alinajm7/Haptisense/README.md

# Haptisense
Documentation and Projects for haptic feedback systems. Explore and contribute to the tactile feedback technology.

# Project General View
- **[Hardware](./hardware/)**
  - **[Electronic_components](./hardware/electronic_components/)**
  - **[Physical_components](./hardware/physical_components/)**
- **[Software](./software/)**
  - **[Microcontroller_firmware](./software/microcontroller_firmware/)**
  - **[UNITY_packages](./software/unity_packages/)**<br>
- [Docs](./docs/)<br>
- [LICENSE.md](./LICENSE.md)<br>
