alinajm7/Haptisense/software/unity_packages/README.md

# Unity Packages

This repository contains useful packages for managing haptic devices and related functionalities.

## Overview of Packages

- **[Haptic Device Controller](./haptic_device_controller):** A package for controlling haptic devices.

Related & Useful packages:
- **[Path Movement (Shape Drawing)](./moving_on_path_(shape_drawing)):** A package for simulating object movement along a path, useful for replicating stroking or shape drawing with a haptic device.
- **[Questionnaire](https://github.com/alinajm7/Unity-Questionnaire.git):** A package for managing questionnaires and collecting results.
