alinajm7/Haptisense/software/unity_packages/haptic_device_controller/ver01 - Device with esp32_wroom_dev/README.md

# Haptic Device Integration for Unity

This guide explains how to integrate the "AliN_HapticDevice" package into your Unity project and provides a manual setup process for configuring the haptic device ver 1.0

## How to Run the Haptic Device

1. **Download the Package:**  
   Download the "AliN_HapticDevice" package and add it to your Unity project.

2. **Sample Scene:**  
   A fully functioning sample scene is provided in the `Sample Scenes` folder to help you get started quickly.

## Manual Setup

To manually set up the haptic device in your Unity project, follow these steps:

### 1. Setting Up the Communication Manager

1. **Create an Empty GameObject:**  
   - In your scene, create an empty GameObject.
   - Add the `MicroControllerCommunicationManager` component to this GameObject.  
  
### 2. Setting Up the Actuator Manager

1. **Create Another Empty GameObject:**  
   - Add an empty GameObject to manage the actuators.
   - This GameObject will serve as the parent for actuator objects.

2. **Add the Following Components:**

   - **Actuators Manager:**  
     Manages the behavior of actuators, including properties like scanning distance, power factor, and distance-based weighting.  
     
     **Properties:**
     - **Scanning Distance:** (`scaningDistance`)  
       Defines the range within which actuators can detect tangible objects. Default is 10 units.
       
     - **Power Factor:** (`powerFactor`)  
       Adjusts the intensity of actuator responses based on proximity. Higher values increase sensitivity to closer objects. Default is 2.0.
       
     - **Minimum Actuator Value Threshold:** (`acuatorMinValueThreshold`)  
       The minimum value an actuator can output. Values below this threshold are considered inactive. Default is 0.14.
       
     - **Maximum Actuator Value:** (`maxActuatorValue`)  
       The maximum intensity an actuator can reach. Default is 1.0.
       
     - **Show Actuator Values:** (`ShowActuatorValues`)  
       Enables or disables the display of actuator values in the scene. Default is enabled.
       
     - **Gradient:** (`gradient`)  
       Defines the color gradient used for visual feedback based on actuator values.

   - **Actuator Data Sender:**  
     Required for the Actuators Manager to send calculated data to the Device Manager.

   - **Optional Components:**
     - **Actuator Layout:**  
       Automatically creates a pattern of actuators based on specified parameters.
       
     - **Actuator Object Mapper:**  
       Maps all actuator cells onto any 3D object surface with a Collider (including Mesh Collider) using ray projecting mapping in specific direction .

### 3. Example Setup

Below is an example image showing a typical setup:

Haptic Device Setup

## Additional Notes

- Ensure all GameObjects with actuators have the necessary components as listed above.
- Use the sample scene for reference if you encounter any issues.
