alinajm7/Haptisense/project_tree_view.md

# Project Tree View
- [LICENSE.md](https://github.com/alinajm7/Haptisense/blob/main/LICENSE.md)
- [README.md](https://github.com/alinajm7/Haptisense/blob/main/README.md)
- [docs](https://github.com/alinajm7/Haptisense/tree/main/docs)/
  - [*](https://github.com/alinajm7/Haptisense/blob/main/docs/*)
- [generate_tree.sh](https://github.com/alinajm7/Haptisense/blob/main/generate_tree.sh)
- [hardware](https://github.com/alinajm7/Haptisense/tree/main/hardware)/
  - [electronic_components](https://github.com/alinajm7/Haptisense/tree/main/hardware/electronic_components)/
    - [01_microcontrollers_modules](https://github.com/alinajm7/Haptisense/tree/main/hardware/electronic_components/01_microcontrollers_modules)/
      - [microcontrollers_note.md](https://github.com/alinajm7/Haptisense/blob/main/hardware/electronic_components/01_microcontrollers_modules/microcontrollers_note.md)
    - [02_power_driver_modules](https://github.com/alinajm7/Haptisense/tree/main/hardware/electronic_components/02_power_driver_modules)/
      - [*](https://github.com/alinajm7/Haptisense/blob/main/hardware/electronic_components/02_power_driver_modules/*)
    - [03_haptic_interface_modules](https://github.com/alinajm7/Haptisense/tree/main/hardware/electronic_components/03_haptic_interface_modules)/
      - [*](https://github.com/alinajm7/Haptisense/blob/main/hardware/electronic_components/03_haptic_interface_modules/*)
    - [10_integrated_designs](https://github.com/alinajm7/Haptisense/tree/main/hardware/electronic_components/10_integrated_designs)/
      - [*](https://github.com/alinajm7/Haptisense/blob/main/hardware/electronic_components/10_integrated_designs/*)
  - [physical_components](https://github.com/alinajm7/Haptisense/tree/main/hardware/physical_components)/
    - [3d_models](https://github.com/alinajm7/Haptisense/tree/main/hardware/physical_components/3d_models)/
      - [cases](https://github.com/alinajm7/Haptisense/tree/main/hardware/physical_components/3d_models/cases)/
        - [*](https://github.com/alinajm7/Haptisense/blob/main/hardware/physical_components/3d_models/cases/*)
    - [laser_cut_files](https://github.com/alinajm7/Haptisense/tree/main/hardware/physical_components/laser_cut_files)/
      - [*](https://github.com/alinajm7/Haptisense/blob/main/hardware/physical_components/laser_cut_files/*)
- [project_tree_view.md](https://github.com/alinajm7/Haptisense/blob/main/project_tree_view.md)
- [software](https://github.com/alinajm7/Haptisense/tree/main/software)/
  - [microcontroller_firmware](https://github.com/alinajm7/Haptisense/tree/main/software/microcontroller_firmware)/
    - [*](https://github.com/alinajm7/Haptisense/blob/main/software/microcontroller_firmware/*)
  - [unity_application](https://github.com/alinajm7/Haptisense/tree/main/software/unity_application)/
    - [*](https://github.com/alinajm7/Haptisense/blob/main/software/unity_application/*)
- [tree_view.md](https://github.com/alinajm7/Haptisense/blob/main/tree_view.md)
