alinajm7/Haptisense/hardware/electronic_components/02_power_driver_modules/Driver_AliNk_02/README.md

Backup of Electronic Components' Schematics and PCB Design in EasyEDA [https://easyeda.com/]
