alinajm7/Haptisense/hardware/electronic_components/01_microcontrollers_modules/Microcontroller_AliNk_02/Dual ESP32 2024/BOM_Dual-ESP32-S3-Controller_2024-10-15.csv

ID | Name | Designator | Footprint | Quantity | Manufacturer Part | Manufacturer | Supplier | Supplier Part | Price | Pins | Contributor | JLCPCB Part Class | LCSC Assembly | Package Display | SMT Type | link
1 | 10uF/25V (20%) | C1 | C0603 | 1 | CL10A106MA8NRNC | SAMSUNG | LCSC | C96446 | 0.017 | 2 | Sanjoy Biswas |  | Yes |  | Extend
2 | 0.1uF/50V(10%) | C2,C3,C4,C10 | C0603 | 4 | 0603B104K500NT | FH(风华) | LCSC | C30926 | 0.002 | 2 | mubashirashfaq | Extended Part |  |  |  | https://lcsc.com/eda_search?q=C30926&%26type=1&ref=editor
3 | 10uF/25V(10%) | C6,C7 | C0805 | 2 | CL21A106KAYNNNE | SAMSUNG(三星) | LCSC | C15850 | 0.01 | 2 |  | Basic Part
4 | 1uF/16V(10%) | C8 | C0603 | 1 | CL10A105KO8NNNC | SAMSUNG(三星) | LCSC | C1592 | 0.003 | 2 |  | Extended Part
5 | 0.1uF | C9 | C0603 | 1 | 0603B104K500NT | FH(风华) | LCSC | C30926 | 0.002 | 2 | mubashirashfaq | Extended Part |  |  |  | https://lcsc.com/eda_search?q=C30926&%26type=1&ref=editor
6 | 10uF | C11 | C0805 | 1 | CL21A106KAYNNNE | SAMSUNG(三星) | LCSC | C15850 | 0.01 | 2 |  | Basic Part
7 | 22uF | C12 | C1206 | 1 | CL31A226KAHNNNE | SAMSUNG(三星) | LCSC | C12891 | 0.045 | 2 |  | Basic Part
8 | 1uF/16V(10%) | C17 | C0603 | 1 | CL10A105KO8NNNC | SAMSUNG | LCSC | C1592 | 0.003 | 2 |  | Extended Part
9 | LESD9D5.0CT5G | D2,D3,D4 | SOD-923_L0.8-W0.6-LS1.0-BI | 3 | LESD9D5.0CT5G | LRC(乐山无线电) | LCSC | C136165 | 0.018 | 2 | LCSC | Extended Part
10 | SS52_C727064 | D5,D6 | SMA_L4.3-W2.6-LS5.1-R-RD | 2 | SS52 | TWGMC(台湾迪嘉) | LCSC | C727064 | 0.046 | 2 | LCSC | Extended Part
11 | AFC24-S60FIC-00 | FPC1 | FPC-SMD_P0.50-60P_QCHF-SM-H2.0 | 1 | AFC24-S60FIC-00 | JS(钜硕电子) | LCSC | C262298 | 0.363 | 62 | LCSC | Extended Part
12 | PZ254R-11-03P | H2 | HDR-TH_3P-P2.54-H-M-W10.4 | 1 | PZ254R-11-03P | XFCN(兴飞) | LCSC | C492411 | 0.019 | 3 | LCSC | Extended Part
13 | D-R080508L3-KS2 | LED1 | LED0805-RD | 1 | D-R080508L3-KS2 | ARKLED(方舟) | LCSC | C130114 | 0.016 | 2 | LCSC | Extended Part
14 | XL-1608UBC-04 | LED4 | LED0603-RD_BLUE | 1 | XL-1608UBC-04 | XINGLIGHT(成兴光) | LCSC | C965807 | 0.003 | 2 | LCSC | Extended Part
15 | XL-1608UGC-04 | LED6 | LED0603-RD_GREEN | 1 | XL-1608UGC-04 | XINGLIGHT(成兴光) | LCSC | C965804 | 0.004 | 2 | lcsc | Extended Part
16 | L8050QLT1G | Q1 | SOT-23-3_L2.9-W1.3-P1.90-LS2.4-BR | 1 | L8050QLT1G | LRC(乐山无线电) | LCSC | C49581 | 0.012 | 3 |  | Extended Part |  | No
17 | L8050QLT1G | Q2 | SOT-23-3_L2.9-W1.3-P1.90-LS2.4-BR | 1 | L8050QLT1G | LRC(乐山无线电) | LCSC | C49581 | 0.012 | 3 |  | Extended Part
18 | 0Ω | R1,R4,R5,R8,R15 | R0603 | 5 | 0603WAF0000T5E | UNI-ROYAL(厚声) | LCSC | C21189 | 0.001 | 2 |  | Basic Part
19 | 10kΩ(0.5%) | R3,R6,R7,R14 | R0603 | 4 | 0603WAD1002T5E | UNI-ROYAL(厚声) | LCSC | C167144 | 0.004 | 2 | LCSC | Extended Part
20 | 4.7kΩ | R9,R10 | R1206 | 2 | PTFR1206B4K70P9 | RESI(开步睿思） | LCSC | C351460 | 0.208 | 2 | LCSC | Extended Part
21 | 47.5kΩ (0.5%) | R12 | R0402 | 1 | AR02DTC4752 | Viking(光颉) | LCSC | C319605 | 0.011 | 2 | LCSC | Extended Part
22 | 1kΩ (0.5%) | R13 | R0402 | 1 | AR02DTD1001 | Viking(光颉) | LCSC | C319807 | 0.011 | 2 | LCSC | Extended Part
23 | 22.1kΩ | R16 | R0402 | 1 | RTT022212FTH | RALEC(旺诠) | LCSC | C102896 | 0.001 | 2 |  | Extended Part
24 | 110Ω | R17,R18 | R0603 | 2 | 0603WAF1100T5E | UNI-ROYAL(厚声) | LCSC | C22781 | 0.001 | 2 |  | Extended Part
25 | 1kΩ | R22 | R0603 | 1 | RT0603BRD071KL | YAGEO(国巨) | LCSC | C110776 | 0.021 | 2 |  | Extended Part
26 | SKRPARE010 | SW1 | KEY-SMD_4P-L4.2-W3.2-P2.20-LS4.6 | 1 | SKRPARE010 | ALPSALPINE(阿尔卑斯阿尔派) | LCSC | C341730 | 0.121 | 4 | LCSC | Extended Part
27 | SKRPACE010 | SW2 | KEY-SMD_4P-L4.2-W3.2-P2.20-LS4.6 | 1 | SKRPACE010 | ALPSALPINE(阿尔卑斯阿尔派) | LCSC | C139797 | 0.056 | 4 | LCSC | Extended Part
28 | K3-2268D-F1 | SW4 | SW-TH_K3-2268D-F1 | 1 | K3-2268D-F1 | 韩国韩荣 | LCSC | C128958 | 0.506 | 12 | LCSC | Extended Part
29 | CP2102N-A02-GQFN28R | U2 | QFN-28_L5.0-W5.0-P0.50-TL-EP3.3 | 1 | CP2102N-A02-GQFN28R | SKYWORKS/SILICON LABS(芯科) | LCSC | C964632 | 2.03 | 29 | LCSC | Extended Part
30 | LM1085R-3.3 | U6 | TO-263-3L_L10.0-W9.2-P2.54-TL | 1 | LM1085R-3.3 | HTC | LCSC | C126016 | 0.614 | 4 |  | Extended Part
31 | ESP32-S3-MINI-1U-N8 | U9,U10 | BULETM-SMD_ESPRESSIF_ESP32-S3-MINI-1U-N8 | 2 | ESP32-S3-MINI-1U-N8 | ESPRESSIF(乐鑫) | LCSC | C2980299 | 3.855 | 65 | LCSC | Extended Part
32 | HC-TYPE-C-16P-01A-G | USB1 | USB-C-SMD_G-SWITCH_GT-USB-7010EN | 1 | HC-TYPE-C-16P-01A-G | HCTL(华灿天禄) | LCSC | C2997435 | 0.133 | 16 | lcsc | Extended Part
