alinajm7/Haptisense/hardware/electronic_components/03_haptic_interface_modules/Interface_AliNk_02/Vibrator Interface Flex 2024/BOM_Vibrator-Interface-Flex-Board_2024-10-15.csv

ID | Name | Designator | Footprint | Quantity | Manufacturer Part | Manufacturer | Supplier | Supplier Part | Price | Pins | Contributor | JLCPCB Part Class | link
1 | 0.1uF | C1,C2,C3,C4,C5,C6,C7,C8,C9,C10,C11,C12,C13,C14,C15,C16,C17,C18,C19,C20,C21,C22,C23,C24,C25,C26,C27,C28,C29,C30,C31,C32,C33,C34,C35,C36,C37,C38,C39,C40,C41,C42,C43,C44,C45,C46,C47,C48,C49,C50,C51,C52,C53,C54,C55,C56,C57,C58 | C0603 | 58 | 0603B104K500NT | FH(风华) | LCSC | C30926 | 0.002 | 2 | mubashirashfaq | Extended Part | https://lcsc.com/eda_search?q=C30926&%26type=1&ref=editor
2 | THD0812F-120BV-GF | CN1 | CONN-SMD_120P-P0.80_THD0812F-120BV-GF | 1 | THD0812F-120BV-GF | THD(台华达) | LCSC | C2841037 | 0.963 | 120 | LCSC | Extended Part
3 | 1N5819WS | D1,D2,D3,D4,D5,D6,D7,D8,D9,D10,D11,D12,D13,D14,D15,D16,D17,D18,D19,D20,D21,D22,D23,D24,D25,D26,D27,D28,D29,D30,D31,D32,D33,D34,D35,D36,D37,D38,D39,D40,D41,D42,D43,D44,D45,D46,D47,D48,D49,D50,D51,D52,D53,D54,D55,D56,D57,D58 | SOD-323_L1.8-W1.3-LS2.5-RD | 58 | 1N5819WS | Hottech(合科泰) | LCSC | C191023 | 0.008 | 2 | LCSC | Basic Part
