alinajm7/Haptisense/hardware/electronic_components/01_microcontrollers_modules/Microcontroller_AliNk_02/Dual ESP32 2024/Schematic_Dual-ESP32-S3-Controller_2024-10-15.pdf

# ESP32-S3

# USB to UART Bridge Circuit

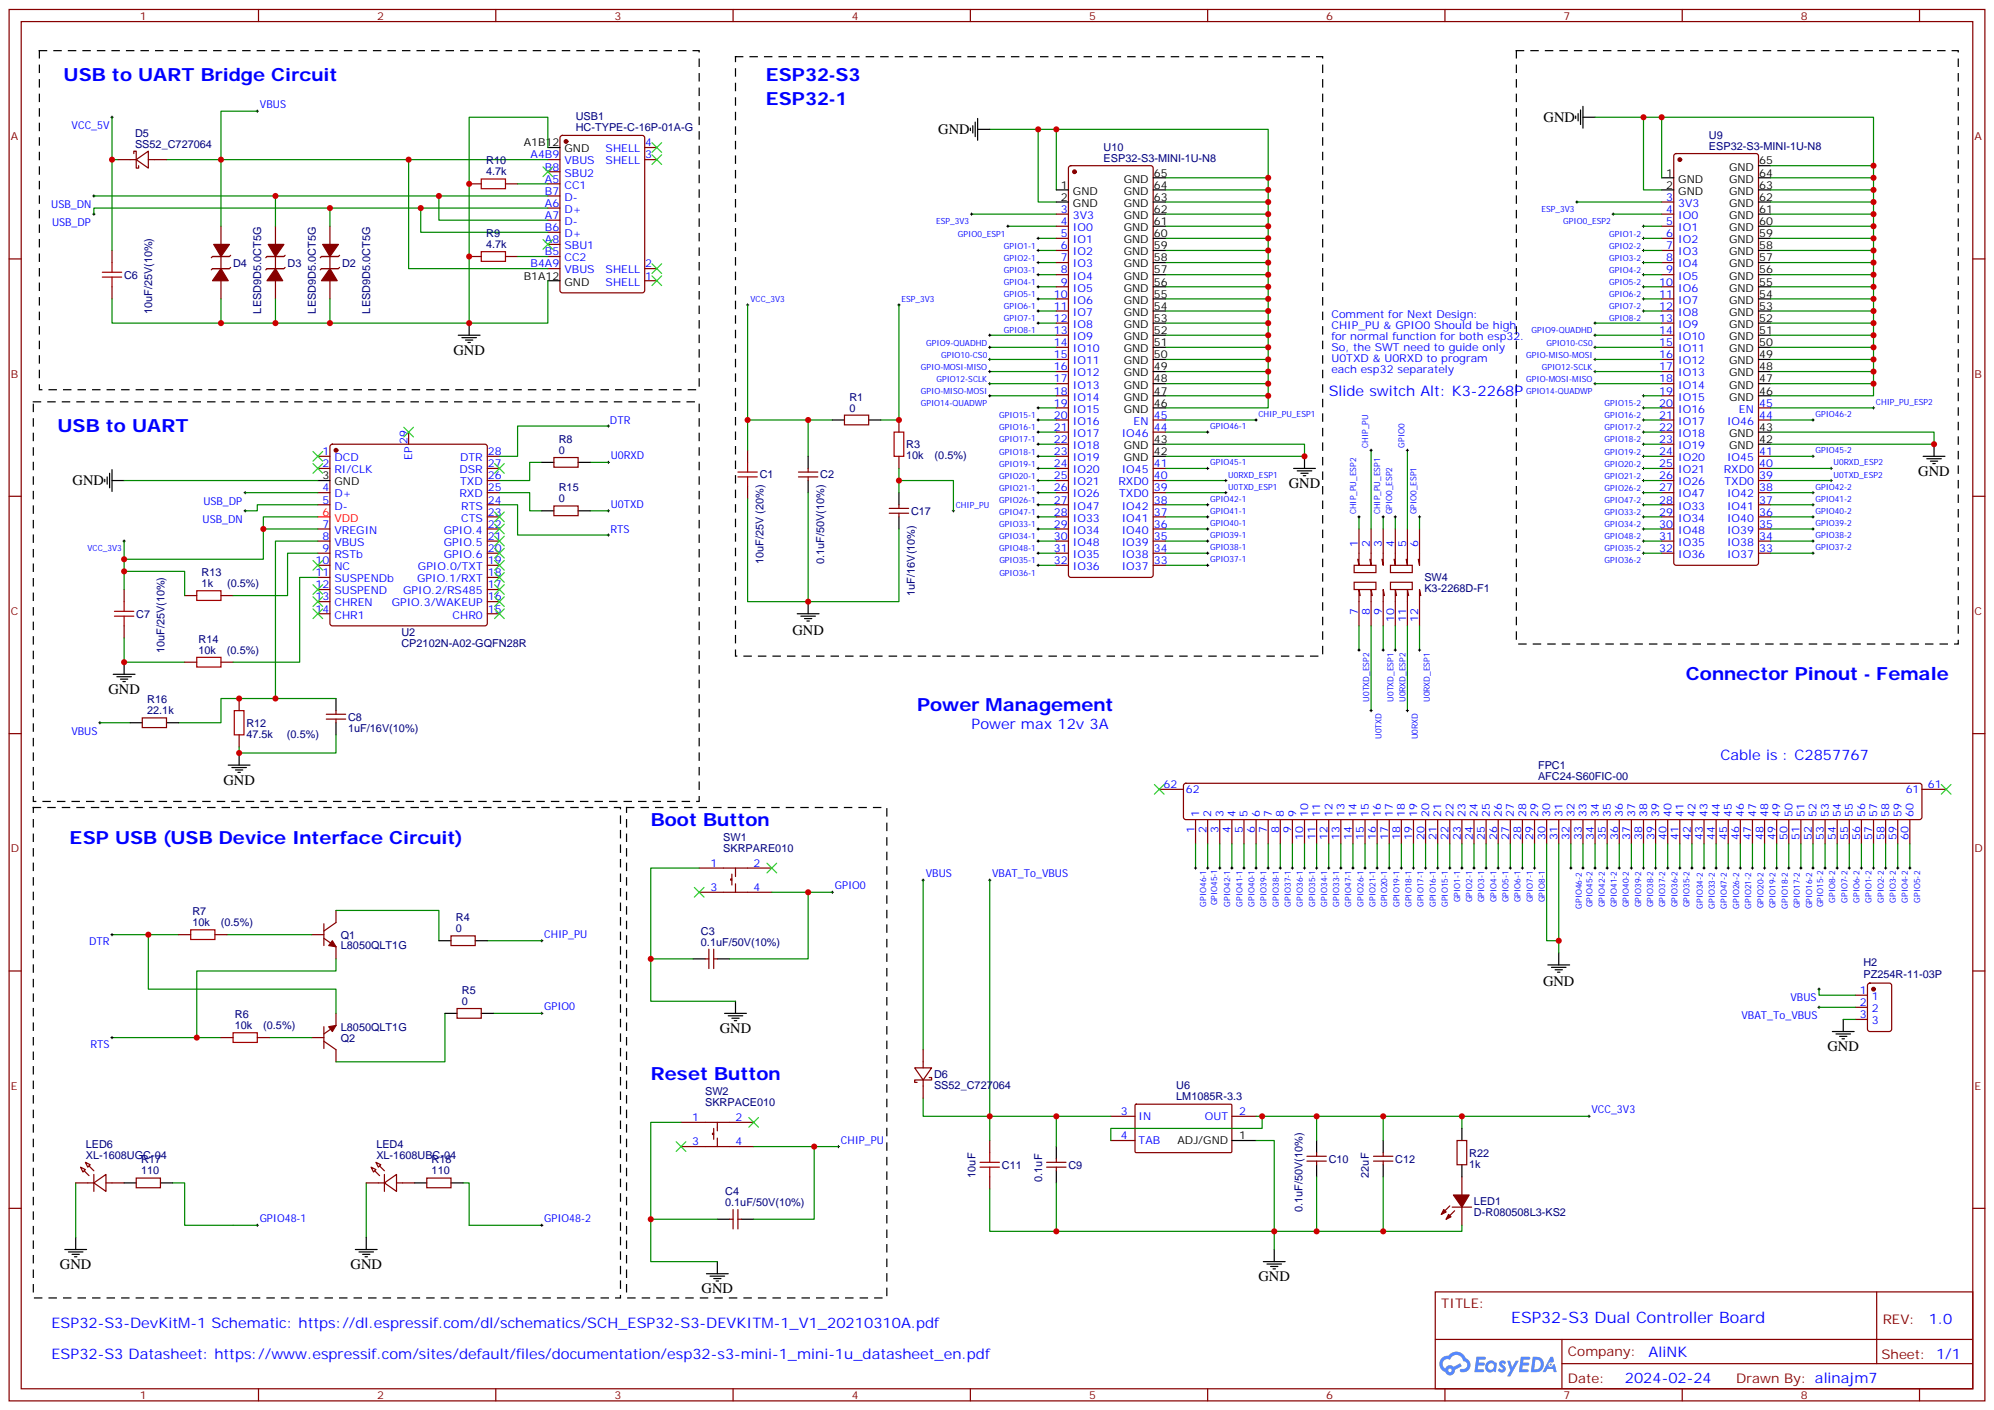
[picture p1: page 1]

Comment for Next Design:
CHIP_PU & GPIO0 Should be high
for normal function for both esp32.
So, the SWT need to guide only
U0TXD & U0RXD to program
each esp32 separately
Slide switch Alt: K3-2268P

ESP USB (USB Device Interface Circuit)

ESP32-S3-DevKitM-1 Schematic: https://dl.espressif.com/dl/schematics/SCH_ESP32-S3-DEVKITM-1_V1_20210310A.pdf
