alinajm7/Haptisense/hardware/electronic_components/03_haptic_interface_modules/Interface_AliNk_02/Vibrator Interface Flex 2024/Schematic_Vibrator-Interface-Flex-Board_2024-10-15.pdf

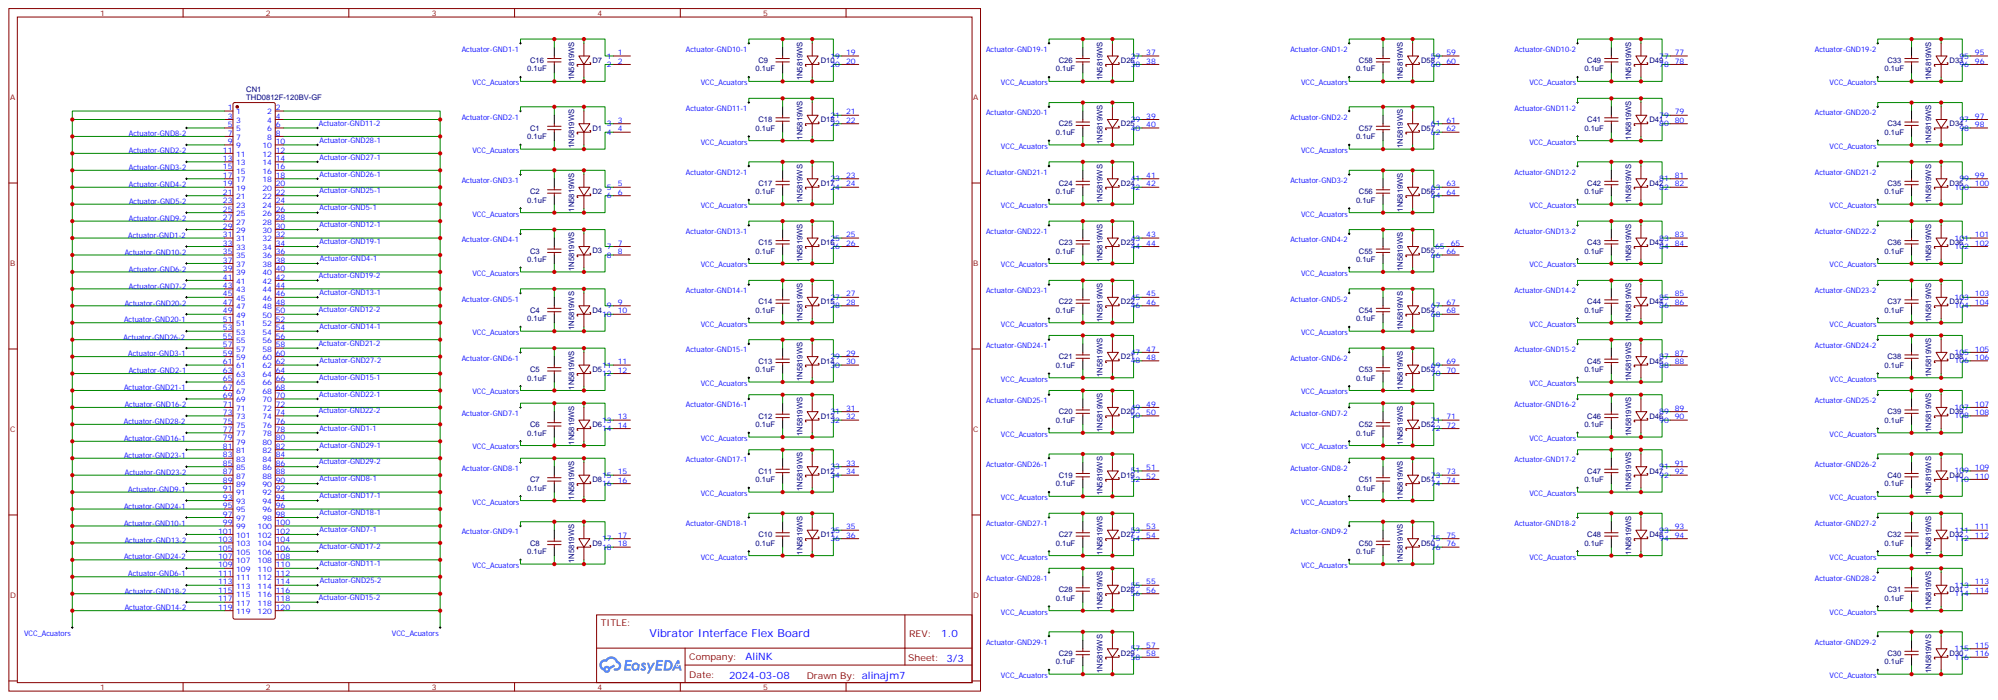
[picture p3: page 1]
