alinajm7/Haptisense/(commit log)

2024-08-09 Questionnaire and path folders
    [Collected data by Index.xlsx]
2024-08-09 add old version of Device manager
2024-08-09 update folder names
    [Collected data by Index.xlsx]
2024-08-14 Update AliN Device
    Updated ActuatorDataSender for handling multiple Actuator Managers.
    Cleaned up the Sample scene.
2024-08-21 separate questionnaire to other repository
    [Collected data by Index.xlsx]
2024-10-15 Update Electronic schematics
    [BOM_Dual-ESP32-S3-Controller_2024-10-15.csv, BOM_MOSFET-Power-Distribution-Board_2024-10-15.csv, BOM_Vibrator-Interface-Flex-Board_2024-10-15.csv]
